mohammadfatemieh/Tigershark3D/PCB-Rev2/Project Outputs for Tigershark 3D rev2 PreProduction Thermistors Version/Rambott.xls

Sheet: BOM Report
Bill of Materials |  |  | <Parameter Title not found>
Source Data From: |  | Rambott
Project: |  | Rambott
Variant: |  | None
Creation Date: | 8/7/2015 | 12:21:47 PM
Print Date: | 2015-08-07 | 12:30:02
Footprint | Comment | LibRef | Designator | Description | Quantity
C0402 | 0402 | GRM155R71H103JA88D, GRM155R71H103JA88D, GRM155R71H103JA88D, GRM155R71H103JA88D, GRM155R71H103JA88D, GRM155R71H103JA88D, 100nF C0402 - GRM155R71C104KA88D, GRM155R71C104KA88D, GRM155R71C104KA88D, GRM155R71H103JA88D, GRM155R71H103JA88D, GRM155R71H103JA88D, GRM155R71H103JA88D, CL05C100JB5NNNC, CL05C100JB5NNNC, GRM155R71H103JA88D, GRM155R60J474KE19D, GRM155R71H103JA88D, GRM155R71H103JA88D, GRM155R71H103JA88D, GRM155R71H103JA88D, GRM155R71H103JA88D, GRM155R71H103JA88D, 100nF C0402 - GRM155R71C104KA88D, GRM155R60J474KE19D, GRM155R60J474KE19D, GRM155R60J474KE19D, GRM155R60J474KE19D, CL05C100JB5NNNC, GRM155R71H103JA88D, GRM155R71H103JA88D, GRM155R71H103JA88D, GRM155R71H103JA88D, GRM155R71H103JA88D, GRM155R71C104KA88D, GRM155R71C104KA88D, GRM155R71C104KA88D, GRM155R71H103JA88D | C1_ES1, C1_ES2, C1_ES3, C2_ES1, C2_ES2, C2_ES3, C18, C20, C26, C37_M1, C37_M2, C37_M3, C37_M4, C43, C44, C49, C50, C51, C63, C68_M1, C68_M2, C68_M3, C68_M4, C70, C71_M1, C71_M2, C71_M3, C71_M4, C73, C75_M1, C75_M2, C75_M3, C75_M4, C84, C85, C86, C87, C89 | CAP CER 10nF 50V X7R 0402, CAP CER 10nF 50V X7R 0402, CAP CER 10nF 50V X7R 0402, CAP CER 10nF 50V X7R 0402, CAP CER 10nF 50V X7R 0402, CAP CER 10nF 50V X7R 0402, Capacitor (Semiconductor SIM Model), CAP CER 0.1UF (100nF) 16V 10% X7R 0402, CAP CER 0.1UF (100nF) 16V 10% X7R 0402, CAP CER 10000PF 50V X7R 0402, CAP CER 10000PF 50V X7R 0402, CAP CER 10000PF 50V X7R 0402, CAP CER 10000PF 50V X7R 0402, CAP CER 10PF 50V 5% NP0 0402, CAP CER 10PF 50V 5% NP0 0402, CAP CER 10000PF 50V X7R 0402, 0.47uF 6.3v C0402 - GRM155R60J474KE19D, CAP CER 10000PF 50V X7R 0402, CAP CER 10nF 50V X7R 0402, CAP CER 10nF 50V X7R 0402, CAP CER 10nF 50V X7R 0402, CAP CER 10nF 50V X7R 0402, CAP CER 10nF 50V X7R 0402, Capacitor (Semiconductor SIM Model), 0.47uF 6.3v C0402 - GRM155R60J474KE19D, 0.47uF 6.3v C0402 - GRM155R60J474KE19D, 0.47uF 6.3v C0402 - GRM155R60J474KE19D, 0.47uF 6.3v C0402 - GRM155R60J474KE19D, CAP CER 10PF 50V 5% NP0 0402, CAP CER 10000PF 50V X7R 0402, CAP CER 10000PF 50V X7R 0402, CAP CER 10000PF 50V X7R 0402, CAP CER 10000PF 50V X7R 0402, CAP CER 10000PF 50V X7R 0402, CAP CER 0.1UF (100nF) 16V 10% X7R 0402, CAP CER 0.1UF (100nF) 16V 10% X7R 0402, CAP CER 0.1UF (100nF) 16V 10% X7R 0402, CAP CER 10000PF 50V X7R 0402 | 38
C0603 | 1nF | C0603C102K5RACTU | C3_M1, C3_M2, C3_M3, C3_M4, C5_M1, C5_M2, C5_M3, C5_M4, C6_M1, C6_M2, C6_M3, C6_M4, C8_M1, C8_M2, C8_M3, C8_M4, C52, C62, C67, C72, C79, C82, C83 | CAP CER 0603 1nF 50v 10% X7R | 23
C0805 | 47uF | CL21A476MQCLRNC | C4 | CAP CER 47UF 6.3V 20% X5R 0805 | 1
C1206 | 4.7uF | C1206C475K5PACTU | C9 | CAP CER 1206 4.7uF 50V 10% X5R | 1
C0805 | 1uF | GRM21BR71H105KA12L | C10 | CAP CER 0805 1uF 50V 10% X7R | 1
C0402 | 100nF | GRM155R71C104KA88D | C11, C23, C25, C27, C30_TR1, C30_TR2, C30_TR3, C30_TR4, C33, C34, C35, C38, C39, C41, C42, C45, C46, C47, C48, C53, C54, C56, C57, C58, C59, C61, C65, C66_M1, C66_M2, C66_M3, C66_M4, C74, C88 | CAP CER 0402 100nF 16V 10% X7R | 33
C0603 | 100nF | C0603C104K5RACTU | C12_M1, C12_M2, C12_M3, C12_M4, C14_M1, C14_M2, C14_M3, C14_M4, C31, C40, C64, C69, C78, C81 | CAP CER 0603 100nF 50V 10% X7R | 14
C0603 | 0603 | C1608JB0J106K080AB | C13, C17, C29, C32, C36, C60 | CAP CER 10UF 6.3V 10% JB 0603 | 6
EEE-1VA101XP | EEE-1VA101XP | EEE-1VA101XP | C15_M1, C15_M2, C15_M3, C15_M4, C16, C90, C91 | CAP ALUM 100UF 35V 20% SMD | 7
C0805 | 10uF | C0805C106K8PACTU | C21, C76 | CAP CER 0805 10uF 10V 10% X5R | 2
C0402 | 1uF | GRM155R60J105KE19D | C22, C28 | CAP CER 0402 1uF 6.3V 10% X5R | 2
C1206 | 10uF 50V | CL31A106KBHNNNE | C55, C77, C80 | CAP CER 10UF 50V 10% X5R 1206 | 3
SOD323-R | MM3Z2V7T1G | MM3Z2V7T1G | D1 | Z-Diode 2.7V 10mA 200mW | 1
SMA-SM | SK310A-TP | SK310A | D2 | DIODE Schottky 3A SMA | 1
SOD523 | 1N4148WT | 1N4148WT | D3_TR1, D3_TR2, D3_TR3, D3_TR4, D5_TR1, D5_TR2, D5_TR3, D5_TR4 | DIODE SOD523 | 8
DO-214AB | S3A-13-F | S3A-13-F | D4, D6, D7 | DIODE DO-214AB | 3
SOD323-R | RSB39VTE-17 | RSB39VTE-17 | D8, D9, D30, D32, D34, D35, D36, D37 | DIODE TVS | 8
LED2012120 | 5988140107F | 5988140107F | D10, D11, D13, D14, D16, D18, D29 | LED 0805 Yellow | 7
SMA-SM | B240A-13-F | SK310A | D12, D15, D17, D19, D31, D33 | DIODE Schottky 3A SMA | 6
SMA-SM | SMAJ30A | SMAJ30A | D20_M1, D20_M2, D20_M3, D20_M4, D21_M1, D21_M2, D21_M3, D21_M4, D22_M1, D22_M2, D22_M3, D22_M4, D23_M1, D23_M2, D23_M3, D23_M4, D25, D26, D27, D28 | DIODE TVS 30V SMA | 20
LED2012120 | 5988110107F | 5988110107F | D24 | LED 0805 Red | 1
SOD923-100X40-2N | ESD9B3.3ST5G | ESD9B3.3ST5G | D38_ES1, D38_ES2, D38_ES3, D39_ES1, D39_ES2, D39_ES3 | 11.5 V 15 pF SMT Transient Voltage Suppressor - SOD-923 | 6
SOT95P230X110-3N | PESDxL2BT | PESDxL2BT | DA4 | PESDxL2BT TVS Diode Array 2x | 1
3557 | 3557-2 | 3557-2 | F1, F2, F3 | FUSE PTH ATO | 3
70543-02 | C-GRID-02-70543 | C-GRID-02-70543 | FAN-1, P2_TR1, P2_TR2, P2_TR3, P2_TR4 | Connector 2pos | 5
PN61729 | USB-B | USB-B | J1 |  | 1
FTSH-105-XX-X-DV | FTSH-105-XX-X-DV | ARM Cortex JTAG-DEBUG Header | J2 |  | 1
XAL50xx-153 | XAL5050-153MEB | XAL5050-153MEB | L1 | IND 15uH 3.9A 20% | 1
C0805 | LQM21FN100M70L | LQM21FN100M70L | L2, L3, L4 | IND 0805 10uH 100mA 780 mOhm 20% | 3
LED2012120 | 5988170107F | 5988170107F | LED1 | LED 0805 Green | 1
OSHW_8X150_NOTEXT | OSHW_LOGO_8MILX0150-NT | OSHW_LOGO_8MILX0150-NT | LOGO1 |  | 1
4POL254 | Molex 0705430003 | Molex 0705430003 Alt | M1_M1, M1_M2, M1_M3, M1_M4, M2, M3, T2, T4 | Molex 4 Pin Clip Connector | 8
70543-03 | Molex 70543-03 | C-GRID-03-70543 | MAX1_ES1, MAX1_ES2, MAX1_ES3, MIN1_ES1, MIN1_ES2, MIN1_ES3 | Connector 2pos 2.54mm locking | 6
HDR2X5 | Header 5X2 | Header 5X2 | P3, P4 | Header, 5-Pin, Dual row | 2
HDR2X12 | Header 12X2 | Header 12X2 | P5 | Header, 12-Pin, Dual row | 1
SOIC8-dual-drain | PHN210T | PHN210T | Q1 | Dual N-channel TrenchMOS intermediate level FET | 1
SOT669 | PSMN7R0-60YS,115 | PSMN7R0-60YS,115 | Q4, Q5, Q6, Q7 | Mosfet N-channel 60V 356A 117W 9.3mOhms | 4
R0603 | 10K | ERJ-3EKF1002V | R1, R7 | RES 0603 10K 100mW 1% | 2
R0402 | 100K | RC1005F104CS | R2_ES1, R2_ES2, R2_ES3, R3_ES1, R3_ES2, R3_ES3, R6, R8_M1, R8_M2, R8_M3, R8_M4, R21, R53, R54, R58, R62, R66, R71, R72, R74, R75 | RES SMD 100K OHM 1% 1/16W 0402 | 21
R0402 | 24r | CRCW040224R0FKED | R5, R15, R16, R18, R20, R22, R85, R86, R89 | Res Thick Film 0402 24 Ohm 1% 0.063W | 9
R0402 | 10K | RC0402FR-0710KP | R9_M1, R9_M2, R9_M3, R9_M4, R27, R28, R29, R31_M1, R31_M2, R31_M3, R31_M4, R34, R35, R37, R40, R50, R73 | RES SMD 10K OHM 1% 1/16W 0402 | 17
R0603 | R0603TBD | R0603TBD | R10, R12 | Resistor | 2
R0603 | 1K | ERJ-3EKF1001V | R11, R25, R26 | RES 0603 1K 100mW 1% | 3
R0603 | 1.8K | RC0603JR-071K8L | R13, R47, R56, R60, R64, R68 | RES 0603 1.8K 100mW 5% | 6
R0603 | 4.7K | ERJ3EKF4701V | R14_TR1, R14_TR2, R14_TR3, R14_TR4, R19_TR1, R19_TR2, R19_TR3, R19_TR4, R42, R43 | RES 0603 4.7K 100mW 1% | 10
R0402 | 200K | CRCW0402200KFKED | R17 | RES 0402 200k 63mW 1% | 1
R0402 | 6.8K | CRCW04026K80FKED | R23 | RES SMD 6.8K OHM 1% 1/16W 0402 | 1
R0402 | 1M | ERJ2GEJ105X | R30_M1, R30_M2, R30_M3, R30_M4, R36 | RES 0402 1M 100mW 5% | 5
2512R-0.55 | 2512 | CSRN2512FTR100 | R32_M1, R32_M2, R32_M3, R32_M4, R33_M1, R33_M2, R33_M3, R33_M4, R38, R39 | RES SMD 0.1 OHM 1% 2W 2512 | 10
R0402 | 10R | RC0402FR-0710RL | R45, R46, R52, R55, R57, R59, R61, R63, R65, R67, R69, R70 | RES SMD 10K OHM 1% 1/16W 0402 | 12
2512R-0.55 | 0.6r | RL2512FK-070R06L | R51 | RES 0.06 OHM 1W 1% 2512 SMD | 1
R0402 | 1k | RK73H1ETTP1001F | R76_ES1, R76_ES2, R76_ES3, R77_ES1, R77_ES2, R77_ES3 | RES 0402 1k 63mW 1% | 6
B3F-31XX | 1571610-2 | 1571610-2 | S1 | SWTCH Momentary Washable | 1
KSC721JLFS | KSC721JLFS | KSC721JLFS | S2 | Switch SPST 1.7 N / 1.8 N J Bend Surface Mount Tactile Switch | 1
502570-0893 - Molex SD | 502570-0893 | 502570-0893 | SD | microSD 502570-0893 Molex Part | 1
MSTBV10 | Molex 0395311010 | 0395311010 - Molex 10 Position Connector | T1 | MSBTV10 10 port connector same as RAMBo | 1
VSSOP10 | LM25011MY/NOPB | LM25011 | U1 | REG BUCK | 1
TDFN1616-6LD-PL-1 | MIC5353-3.3YMT-TR | MIC5353-3.3YMT-TR | U2 | LDO 3.3V 500mA - low ESR Cout | 1
LQFP144_N | ATML-ATSAM3X-LQFP-144 | ATML-ATSAM3X-LQFP-144 | U3 |  | 1
SOT26P285X140-6L | ZXGD3009E6 | ZXGD3009E6 | U4, U8, U10, U11, U12, U13 | MOSFET DRVR 3A 1-OUT High Speed Non-Inv6-Pin SOT-26 T/R | 6
DRV8825PWPR | DRV8825 | DRV8825 | U5, U7_M1, U7_M2, U7_M3, U7_M4 | DRV8825 Ti Stepper Driver | 5
ADuM4160 | ADuM4160 | ADuM4160 | U6 | USB Opto Isolator | 1
S25FL216K0PMFI041 | S25FL216K0PMFI041 | S25FL216K0PMFI041 | U9 |  | 1
CRYS320250 | 405C35B12M00000 | 405C35B12M00000 | X2 | Crystal 12.0000MHz 10ppm 10pF | 1
 |  |  |  |  | 358
Approved |  | Notes

Sheet: Project Information
Project Full Path | C:\Users\johnny\Documents\GitHub\Tigershark3D\PCB-Rev2\Tigershark 3D rev2 PreProduction Thermistors Version.PrjPcb
Project Filename | Tigershark 3D rev2 PreProduction Thermistors Version.PrjPcb
Variant Name | None
Data-Source Filename | Tigershark 3D rev2 PreProduction Thermistors Version.PrjPcb
Data-Source Full Path | C:\Users\johnny\Documents\GitHub\Tigershark3D\PCB-Rev2\Tigershark 3D rev2 PreProduction Thermistors Version.PrjPcb
Title | <Parameter Title not found>
Total Quantity | 483
Report Time | 12:21:47 PM
Report Date | 8/7/2015
Report Date & Tine | 8/7/2015 12:21:47 PM
Output Name | Bill of Materials
Output Type | BOM_PartType
Output Generator Name | BOM
Output Generator Description | Bill of Materials
