mohammadfatemieh/Tigershark3D/PCB-Rev2/Project Outputs for Tigershark 3D rev2 PreProduction Thermistors Version/Tigershark 3D rev2 PreProduction Thermistors Version1.xlsx

Comment | Description | Designator | Footprint | LibRef | Quantity
4.7nF, 4.7nF, 4.7nF, 4.7nF, 4.7nF, 4.7nF, 100nF, 0402, 4.7nF, 0402, 1uF, 100nF, 0402, 0402, 100nF, 1uF, 100nF, 100nF, 100nF, 100nF, 100nF, 100nF, 100nF, 100nF, 100nF, 100nF, 100nF, 0402, 0402, 100nF, 100nF, 100nF, 100nF, 0402, 0402, 0402, 100nF, 100nF, 100nF, 100nF, 100nF, 100nF, 100nF, 100nF, 100nF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
1nF, 1nF, 1nF, 1nF, 1nF, 1nF, 1nF, 1nF, 1nF, 1nF, 1nF, 1nF, 1nF, 1nF, 1nF, 1nF, 100nF, 100nF, 100nF, 100nF, 0603, 100nF, 100nF, 100nF, 100nF, 0603, 0603, 100nF, 0603, 0603, 100nF, 1nF, 0603, 1nF, 100nF, 1nF, 100nF, 1nF, 100nF, 1nF, 100nF, 1nF, 1nF | CAP CER 0603 1nF 50v 10% X7R, CAP CER 0603 1nF 50v 10% X7R, CAP CER 0603 1nF 50v 10% X7R, CAP CER 0603 1nF 50v 10% X7R, CAP CER 0603 1nF 50v 10% X7R, CAP CER 0603 1nF 50v 10% X7R, CAP CER 0603 1nF 50v 10% X7R, CAP CER 0603 1nF 50v 10% X7R, CAP CER 0603 1nF 50v 10% X7R, CAP CER 0603 1nF 50v 10% X7R, CAP CER 0603 1nF 50v 10% X7R, CAP CER 0603 1nF 50v 10% X7R, CAP CER 0603 1nF 50v 10% X7R, CAP CER 0603 1nF 50v 10% X7R, CAP CER 0603 1nF 50v 10% X7R, CAP CER 0603 1nF 50v 10% X7R, CAP CER 0603 100nF 50V 10% X7R, CAP CER 0603 100nF 50V 10% X7R, CAP CER 0603 100nF 50V 10% X7R, CAP CER 0603 100nF 50V 10% X7R, CAP CER 10UF 6.3V 10% JB 0603, CAP CER 0603 100nF 50V 10% X7R, CAP CER 0603 100nF 50V 10% X7R, CAP CER 0603 100nF 50V 10% X7R, CAP CER 0603 100nF 50V 10% X7R, CAP CER 10UF 6.3V 10% JB 0603, CAP CER 10UF 6.3V 10% JB 0603, CAP CER 0603 100nF 50V 10% X7R, CAP CER 10UF 6.3V 10% JB 0603, CAP CER 10UF 6.3V 10% JB 0603, CAP CER 0603 100nF 50V 10% X7R, CAP CER 0603 1nF 50v 10% X7R, CAP CER 10UF 6.3V 10% JB 0603, CAP CER 0603 1nF 50v 10% X7R, CAP CER 0603 100nF 50V 10% X7R, CAP CER 0603 1nF 50v 10% X7R, CAP CER 0603 100nF 50V 10% X7R, CAP CER 0603 1nF 50v 10% X7R, CAP CER 0603 100nF 50V 10% X7R, CAP CER 0603 1nF 50v 10% X7R, CAP CER 0603 100nF 50V 10% X7R, CAP CER 0603 1nF 50v 10% X7R, CAP CER 0603 1nF 50v 10% X7R | C3_M1, C3_M2, C3_M3, C3_M4, C5_M1, C5_M2, C5_M3, C5_M4, C6_M1, C6_M2, C6_M3, C6_M4, C8_M1, C8_M2, C8_M3, C8_M4, C12_M1, C12_M2, C12_M3, C12_M4, C13, C14_M1, C14_M2, C14_M3, C14_M4, C17, C29, C31, C32, C36, C40, C52, C60, C62, C64, C67, C69, C72, C78, C79, C81, C82, C83 | C0603 | C0603C102K5RACTU, C0603C102K5RACTU, C0603C102K5RACTU, C0603C102K5RACTU, C0603C102K5RACTU, C0603C102K5RACTU, C0603C102K5RACTU, C0603C102K5RACTU, C0603C102K5RACTU, C0603C102K5RACTU, C0603C102K5RACTU, C0603C102K5RACTU, C0603C102K5RACTU, C0603C102K5RACTU, C0603C102K5RACTU, C0603C102K5RACTU, C0603C104K5RACTU, C0603C104K5RACTU, C0603C104K5RACTU, C0603C104K5RACTU, C1608JB0J106K080AB, C0603C104K5RACTU, C0603C104K5RACTU, C0603C104K5RACTU, C0603C104K5RACTU, C1608JB0J106K080AB, C1608JB0J106K080AB, C0603C104K5RACTU, C1608JB0J106K080AB, C1608JB0J106K080AB, C0603C104K5RACTU, C0603C102K5RACTU, C1608JB0J106K080AB, C0603C102K5RACTU, C0603C104K5RACTU, C0603C102K5RACTU, C0603C104K5RACTU, C0603C102K5RACTU, C0603C104K5RACTU, C0603C102K5RACTU, C0603C104K5RACTU, C0603C102K5RACTU, C0603C102K5RACTU | 43
47uF, 1uF, 10uF, 10uF, LQM21FN100M70L, LQM21FN100M70L, LQM21FN100M70L | CAP CER 47UF 6.3V 20% X5R 0805, CAP CER 0805 1uF 50V 10% X7R, CAP CER 0805 10uF 10V 10% X5R, CAP CER 0805 10uF 10V 10% X5R, IND 0805 10uH 100mA 780 mOhm 20%, IND 0805 10uH 100mA 780 mOhm 20%, IND 0805 10uH 100mA 780 mOhm 20% | C4, C10, C21, C76, L2, L3, L4 | C0805 | CL21A476MQCLRNC, GRM21BR71H105KA12L, C0805C106K8PACTU, C0805C106K8PACTU, LQM21FN100M70L, LQM21FN100M70L, LQM21FN100M70L | 7
470uF | CAP ALU 470uF 50V 20% | C7 | C12,5-5 | UPW1H471MHD1TO | 1
4.7uF, 10uF 50V, 10uF 50V, 10uF 50V | CAP CER 1206 4.7uF 50V 10% X5R, CAP CER 10UF 50V 10% X5R 1206, CAP CER 10UF 50V 10% X5R 1206, CAP CER 10UF 50V 10% X5R 1206 | C9, C55, C77, C80 | C1206 | C1206C475K5PACTU, CL31A106KBHNNNE, CL31A106KBHNNNE, CL31A106KBHNNNE | 4
EEE-1VA101XP | CAP ALUM 100UF 35V 20% SMD | C15, C16 | EEE-1VA101XP | EEE-1VA101XP | 2
SZMM3Z4V7T1G, RSB39VTE-17, RSB39VTE-17 | Z-Diode 2.7V 10mA 200mW, DIODE TVS, DIODE TVS | D1, D8, D9 | SOD323-R | MM3Z2V7T1G, RSB39VTE-17, RSB39VTE-17 | 3
SK310A-TP, SMAJ30A, SMAJ30A, SMAJ30A, SMAJ30A, SMAJ30A, SMAJ30A, SMAJ30A, SMAJ30A, SMAJ30A, SMAJ30A, SMAJ30A, SMAJ30A, SMAJ30A, SMAJ30A, SMAJ30A, SMAJ30A, SMAJ30A, SMAJ30A, SMAJ30A, SMAJ30A | DIODE Schottky 3A SMA, DIODE TVS 30V SMA, DIODE TVS 30V SMA, DIODE TVS 30V SMA, DIODE TVS 30V SMA, DIODE TVS 30V SMA, DIODE TVS 30V SMA, DIODE TVS 30V SMA, DIODE TVS 30V SMA, DIODE TVS 30V SMA, DIODE TVS 30V SMA, DIODE TVS 30V SMA, DIODE TVS 30V SMA, DIODE TVS 30V SMA, DIODE TVS 30V SMA, DIODE TVS 30V SMA, DIODE TVS 30V SMA, DIODE TVS 30V SMA, DIODE TVS 30V SMA, DIODE TVS 30V SMA, DIODE TVS 30V SMA | D2, D20_M1, D20_M2, D20_M3, D20_M4, D21_M1, D21_M2, D21_M3, D21_M4, D22_M1, D22_M2, D22_M3, D22_M4, D23_M1, D23_M2, D23_M3, D23_M4, D25, D26, D27, D28 | SMA-SM | SK310A, SMAJ30A, SMAJ30A, SMAJ30A, SMAJ30A, SMAJ30A, SMAJ30A, SMAJ30A, SMAJ30A, SMAJ30A, SMAJ30A, SMAJ30A, SMAJ30A, SMAJ30A, SMAJ30A, SMAJ30A, SMAJ30A, SMAJ30A, SMAJ30A, SMAJ30A, SMAJ30A | 21
1N4148WT | DIODE SOD523 | D3_TR1, D3_TR2, D3_TR3, D3_TR4, D5_TR1, D5_TR2, D5_TR3, D5_TR4 | SOD523 | 1N4148WT | 8
S3A-13-F | DIODE DO-214AB | D4, D6, D7 | DO-214AB | S3A-13-F | 3
5988140107F, 5988140107F, 5988140107F, 5988140107F, 5988140107F, 5988140107F, 5988140107F, 5988140107F, 5988170107F | LED 0805 Yellow, LED 0805 Yellow, LED 0805 Yellow, LED 0805 Yellow, LED 0805 Yellow, LED 0805 Yellow, LED 0805 Yellow, LED 0805 Yellow, LED 0805 Green | D10, D11, D13, D14, D16, D18, D24, D29, LED1 | LED2012120 | 5988140107F, 5988140107F, 5988140107F, 5988140107F, 5988140107F, 5988140107F, 5988140107F, 5988140107F, 5988170107F | 9
B240A-13-F | Schottky Diode | D12, D15, D17, D19 | SK310A-TP | D Schottky | 4
PESDxL2BT | PESDxL2BT TVS Diode Array 2x | DA1, DA2, DA3, DA4 | SOT95P230X110-3N | PESDxL2BT | 4
3557-2 | FUSE PTH ATO | F1, F2, F3 | 3557 | 3557-2 | 3
C-GRID-02-70543 | Connector 2pos | FAN-1, P2_TR1, P2_TR2, P2_TR3, P2_TR4 | 70543-02 | C-GRID-02-70543 | 5
FIDUCIAL |  | FD1, FD2, FD3 | FIDUCIAL-1X2 | FIDUCIAL | 3
TP4 | Socket | GND_TP, TP1_M1, TP1_M2, TP1_M3, TP1_M4, TP2, TP3, TP4, TP5, TP6, TP7, TP8, TP9_ES1, TP9_ES2, TP9_ES3, TP10_ES1, TP10_ES2, TP10_ES3, TP11, TP12, TP13, TP14, TP15, TP16, TP17, TP18, TP19, TP20, TP21, TP22, TP23, TP24_M1, TP24_M2, TP24_M3, TP24_M4, TP25_M1, TP25_M2, TP25_M3, TP25_M4, TP26_M1, TP26_M2, TP26_M3, TP26_M4, TP27_M1, TP27_M2, TP27_M3, TP27_M4, TP28, TP29, TP30, TP31, TP32_M1, TP32_M2, TP32_M3, TP32_M4, TP33_M1, TP33_M2, TP33_M3, TP33_M4, TP34, TP35_M1, TP35_M2, TP35_M3, TP35_M4, TP36_M1, TP36_M2, TP36_M3, TP36_M4, TP37_M1, TP37_M2, TP37_M3, TP37_M4, TP38, TP39_M1, TP39_M2, TP39_M3, TP39_M4, TP40_M1, TP40_M2, TP40_M3, TP40_M4, TP41, TP42, TP43, TP44, TP45, TP46, TP47, TP48, TP49, TP50, TP51, TP52_TR1, TP52_TR2, TP52_TR3, TP52_TR4, TP53, TP54, TP55, TP56, TP57, TP58, TP59, TP60, TP61, TP62 | TP-2 | Socket | 106
USB-B |  | J1 | PN61729 | USB-B | 1
FTSH-105-XX-X-DV |  | J2 | FTSH-105-XX-X-DV | ARM Cortex JTAG-DEBUG Header | 1
SJ | SMD solder jumper | JP1 | SJ | SJ | 1
XAL5050-153MEB | IND 15uH 3.9A 20% | L1 | XAL50XX-153 | XAL5050-153MEB | 1
OSHW_LOGO_8MILX0150-NT |  | LOGO1 | OSHW_8X150_NOTEXT | OSHW_LOGO_8MILX0150-NT | 1
Molex 0705430003 | Molex 4 Pin Clip Connector | M1_M1, M1_M2, M1_M3, M1_M4, M2, M3, T4 | 4POL254 | Molex 0705430003 Alt | 7
Molex 70543-03 | Connector 2pos 2.54mm locking | MAX1_ES1, MAX1_ES2, MAX1_ES3, MIN1_ES1, MIN1_ES2, MIN1_ES3 | 70543-03 | C-GRID-03-70543 | 6
ERASE | Header, 2-Pin | P1 | HDR1X2 | Header 2 | 1
Header 5X2 | Header, 5-Pin, Dual row | P3, P4, P5, P6 | HDR2X5 | Header 5X2 | 4
NCV8402AD |  | Q1 | NCV8402AD-SOIC8 | NCV8402AD | 1
PSMN7R0-60YS,115 | Mosfet N-channel 60V 356A 117W 9.3mOhms | Q4, Q5, Q6, Q7 | SOT669 | PSMN7R0-60YS,115 | 4
10K, 10K, 10K, 1K, 10K, 1.8K, 4.7K, 4.7K, 4.7K, 4.7K, 24r, 24r, 24r, 4.7K, 4.7K, 4.7K, 4.7K, 24r, 10K, 1K, 1K, 10K, 10K, 10K, 10K, 10K, 4.7K, 4.7K, 10r, 1.8K, 10r, 1.8K, 10r, 1.8K, 10r, 1.8K, 10r, 1.8K, 10r | RES 0603 10K 100mW 1%, RES 0603 10K 100mW 1%, RES 0603 10K 100mW 1%, RES 0603 1K 100mW 1%, RES 0603 10K 100mW 1%, RES 0603 1.8K 100mW 5%, RES 0603 4.7K 100mW 1%, RES 0603 4.7K 100mW 1%, RES 0603 4.7K 100mW 1%, RES 0603 4.7K 100mW 1%, RES SMD 24 OHM 1% 1/10W 0603, RES SMD 24 OHM 1% 1/10W 0603, RES SMD 24 OHM 1% 1/10W 0603, RES 0603 4.7K 100mW 1%, RES 0603 4.7K 100mW 1%, RES 0603 4.7K 100mW 1%, RES 0603 4.7K 100mW 1%, RES SMD 24 OHM 1% 1/10W 0603, RES 0603 10K 100mW 1%, RES 0603 1K 100mW 1%, RES 0603 1K 100mW 1%, RES 0603 10K 100mW 1%, RES 0603 10K 100mW 1%, RES 0603 10K 100mW 1%, RES 0603 10K 100mW 1%, RES 0603 10K 100mW 1%, RES 0603 4.7K 100mW 1%, RES 0603 4.7K 100mW 1%, RES 0603 10r 100mW 1%, RES 0603 1.8K 100mW 5%, RES 0603 10r 100mW 1%, RES 0603 1.8K 100mW 5%, RES 0603 10r 100mW 1%, RES 0603 1.8K 100mW 5%, RES 0603 10r 100mW 1%, RES 0603 1.8K 100mW 5%, RES 0603 10r 100mW 1%, RES 0603 1.8K 100mW 5%, RES 0603 10r 100mW 1% | R1, R7, R10, R11, R12, R13, R14_TR1, R14_TR2, R14_TR3, R14_TR4, R15, R16, R18, R19_TR1, R19_TR2, R19_TR3, R19_TR4, R20, R21, R25, R26, R28, R29, R34, R35, R40, R42, R43, R45, R47, R52, R56, R58, R60, R62, R64, R66, R68, R70 | R0603 | ERJ-3EKF1002V, ERJ-3EKF1002V, ERJ-3EKF1002V, ERJ-3EKF1001V, ERJ-3EKF1002V, RC0603JR-071K8L, ERJ3EKF4701V, ERJ3EKF4701V, ERJ3EKF4701V, ERJ3EKF4701V, RC1608F240CS, RC1608F240CS, RC1608F240CS, ERJ3EKF4701V, ERJ3EKF4701V, ERJ3EKF4701V, ERJ3EKF4701V, RC1608F240CS, ERJ-3EKF1002V, ERJ-3EKF1001V, ERJ-3EKF1001V, ERJ-3EKF1002V, ERJ-3EKF1002V, ERJ-3EKF1002V, ERJ-3EKF1002V, ERJ-3EKF1002V, ERJ3EKF4701V, ERJ3EKF4701V, CRCW060310R0FKEA, RC0603JR-071K8L, CRCW060310R0FKEA, RC0603JR-071K8L, CRCW060310R0FKEA, RC0603JR-071K8L, CRCW060310R0FKEA, RC0603JR-071K8L, CRCW060310R0FKEA, RC0603JR-071K8L, CRCW060310R0FKEA | 39
2.7K, 2.7K, 2.7K, 2.7K, 2.7K, 2.7K, NP, NP, NP, NP, 39r, 100K, 2.7K, 2.7K, 2.7K, 2.7K, 200K, 39r, 6.8K, 1M, 2.7K, 1M, 1M, 1M, 1M, 2.7K, 2.7K, 2.7K, 2.7K, 1M, 2.7K, 1M, NP, NP, NP, NP, 100K, NP, NP, 100K, 100K, 100K, 100K, 100K | RES SMD 2.7K OHM 5% 1/10W 0402, RES SMD 2.7K OHM 5% 1/10W 0402, RES SMD 2.7K OHM 5% 1/10W 0402, RES SMD 2.7K OHM 5% 1/10W 0402, RES SMD 2.7K OHM 5% 1/10W 0402, RES SMD 2.7K OHM 5% 1/10W 0402, Resistor, Resistor, Resistor, Resistor, RES SMD 39 OHM 1% 1/10W 0402, RES SMD 100K OHM 1% 1/16W 0402, RES SMD 2.7K OHM 1% 1/10W 0402, RES SMD 2.7K OHM 1% 1/10W 0402, RES SMD 2.7K OHM 1% 1/10W 0402, RES SMD 2.7K OHM 1% 1/10W 0402, RES 0402 22r 63mW 1%, RES SMD 39 OHM 1% 1/10W 0402, RES SMD 6.8K OHM 1% 1/16W 0402, RES 0402 1M 100mW 5%, RES SMD 2.7K OHM 1% 1/10W 0402, RES 0402 1M 100mW 5%, RES 0402 1M 100mW 5%, RES 0402 1M 100mW 5%, RES 0402 1M 100mW 5%, RES SMD 2.7K OHM 1% 1/10W 0402, RES SMD 2.7K OHM 1% 1/10W 0402, RES SMD 2.7K OHM 1% 1/10W 0402, RES SMD 2.7K OHM 1% 1/10W 0402, RES 0402 1M 100mW 5%, RES SMD 2.7K OHM 1% 1/10W 0402, RES 0402 1M 100mW 5%, Resistor, Resistor, Resistor, Resistor, RES SMD 100K OHM 1% 1/16W 0402, Resistor, Resistor, RES SMD 100K OHM 1% 1/16W 0402, RES SMD 100K OHM 1% 1/16W 0402, RES SMD 100K OHM 1% 1/16W 0402, RES SMD 100K OHM 1% 1/16W 0402, RES SMD 100K OHM 1% 1/16W 0402 | R2_ES1, R2_ES2, R2_ES3, R3_ES1, R3_ES2, R3_ES3, R4_M1, R4_M2, R4_M3, R4_M4, R5, R6, R8_M1, R8_M2, R8_M3, R8_M4, R17, R22, R23, R24, R27, R30_M1, R30_M2, R30_M3, R30_M4, R31_M1, R31_M2, R31_M3, R31_M4, R36, R37, R41, R44_M1, R44_M2, R44_M3, R44_M4, R46, R48, R49, R55, R59, R63, R67, R71 | R0402 | ERJ-2GEJ272X, ERJ-2GEJ272X, ERJ-2GEJ272X, ERJ-2GEJ272X, ERJ-2GEJ272X, ERJ-2GEJ272X, Resistor, Resistor, Resistor, Resistor, ERJ-2RKF39R0X, RC1005F104CS, ERJ-2RKF2701X, ERJ-2RKF2701X, ERJ-2RKF2701X, ERJ-2RKF2701X, CRCW0402200KFKED, ERJ-2RKF39R0X, CRCW04026K80FKED, ERJ2GEJ105X, ERJ-2RKF2701X, ERJ2GEJ105X, ERJ2GEJ105X, ERJ2GEJ105X, ERJ2GEJ105X, ERJ-2RKF2701X, ERJ-2RKF2701X, ERJ-2RKF2701X, ERJ-2RKF2701X, ERJ2GEJ105X, ERJ-2RKF2701X, ERJ2GEJ105X, Resistor, Resistor, Resistor, Resistor, RC1005F104CS, Resistor, Resistor, RC1005F104CS, RC1005F104CS, RC1005F104CS, RC1005F104CS, RC1005F104CS | 44
0.6r, 2512, 2512, 2512, 2512, 2512, 2512, 2512, 2512, 2512, 2512 | RES 0.06 OHM 1W 1% 2512 SMD, RES SMD 0.1 OHM 1% 2W 2512, RES SMD 0.1 OHM 1% 2W 2512, RES SMD 0.1 OHM 1% 2W 2512, RES SMD 0.1 OHM 1% 2W 2512, RES SMD 0.1 OHM 1% 2W 2512, RES SMD 0.1 OHM 1% 2W 2512, RES SMD 0.1 OHM 1% 2W 2512, RES SMD 0.1 OHM 1% 2W 2512, RES SMD 0.1 OHM 1% 2W 2512, RES SMD 0.1 OHM 1% 2W 2512 | R9, R32_M1, R32_M2, R32_M3, R32_M4, R33_M1, R33_M2, R33_M3, R33_M4, R38, R39 | 2512R-0.55 | RL2512FK-070R06L, CSRN2512FTR100, CSRN2512FTR100, CSRN2512FTR100, CSRN2512FTR100, CSRN2512FTR100, CSRN2512FTR100, CSRN2512FTR100, CSRN2512FTR100, CSRN2512FTR100, CSRN2512FTR100 | 11
1571610-2 | SWTCH Momentary Washable | S1 | B3F-31XX | 1571610-2 | 1
502570-0893 | microSD 502570-0893 Molex Part | SD | 502570-0893 - Molex SD | 502570-0893 | 1
Molex 0395311010 | MSBTV10 10 port connector same as RAMBo | T1 | MSTBV10 | 0395311010 - Molex 10 Position Connector | 1
MSTBV6 | PHOENIX | T3 | MSTBV6 | MSTBV6 | 1
LM25011MY/NOPB | REG BUCK | U1 | VSSOP10 | LM25011 | 1
MIC5353-3.3YMT-TR | LDO 3.3V 500mA - low ESR Cout | U2 | TDFN1616-6LD-PL-1 | MIC5353-3.3YMT-TR | 1
ATML-ATSAM3X-LQFP-144 |  | U3 | LQFP144_N | ATML-ATSAM3X-LQFP-144 | 1
DRV8825 | DRV8825 Ti Stepper Driver | U5, U7_M1, U7_M2, U7_M3, U7_M4 | DRV8825PWPR | DRV8825 | 5
ADuM4160 | USB Opto Isolator | U6 | ADuM4160 | ADuM4160 | 1
TXB0106 Level Shifter | TXB0106 - Bidriectional Opendrain/pushpull level shift | U8 | TSOP65P640X120-16N | TXB0106 | 1
S25FL216K0PMFI041 |  | U9 | S25FL216K0PMFI041 | S25FL216K0PMFI041 | 1
7M-12.000MEEQ-T | Crystal 12.0000MHz 10ppm 10pF | X2 | CRYS320250 | 7M-12.000MEEQ-T | 1
