mohammadfatemieh/Tigershark3D/Schematic Prints.pdf

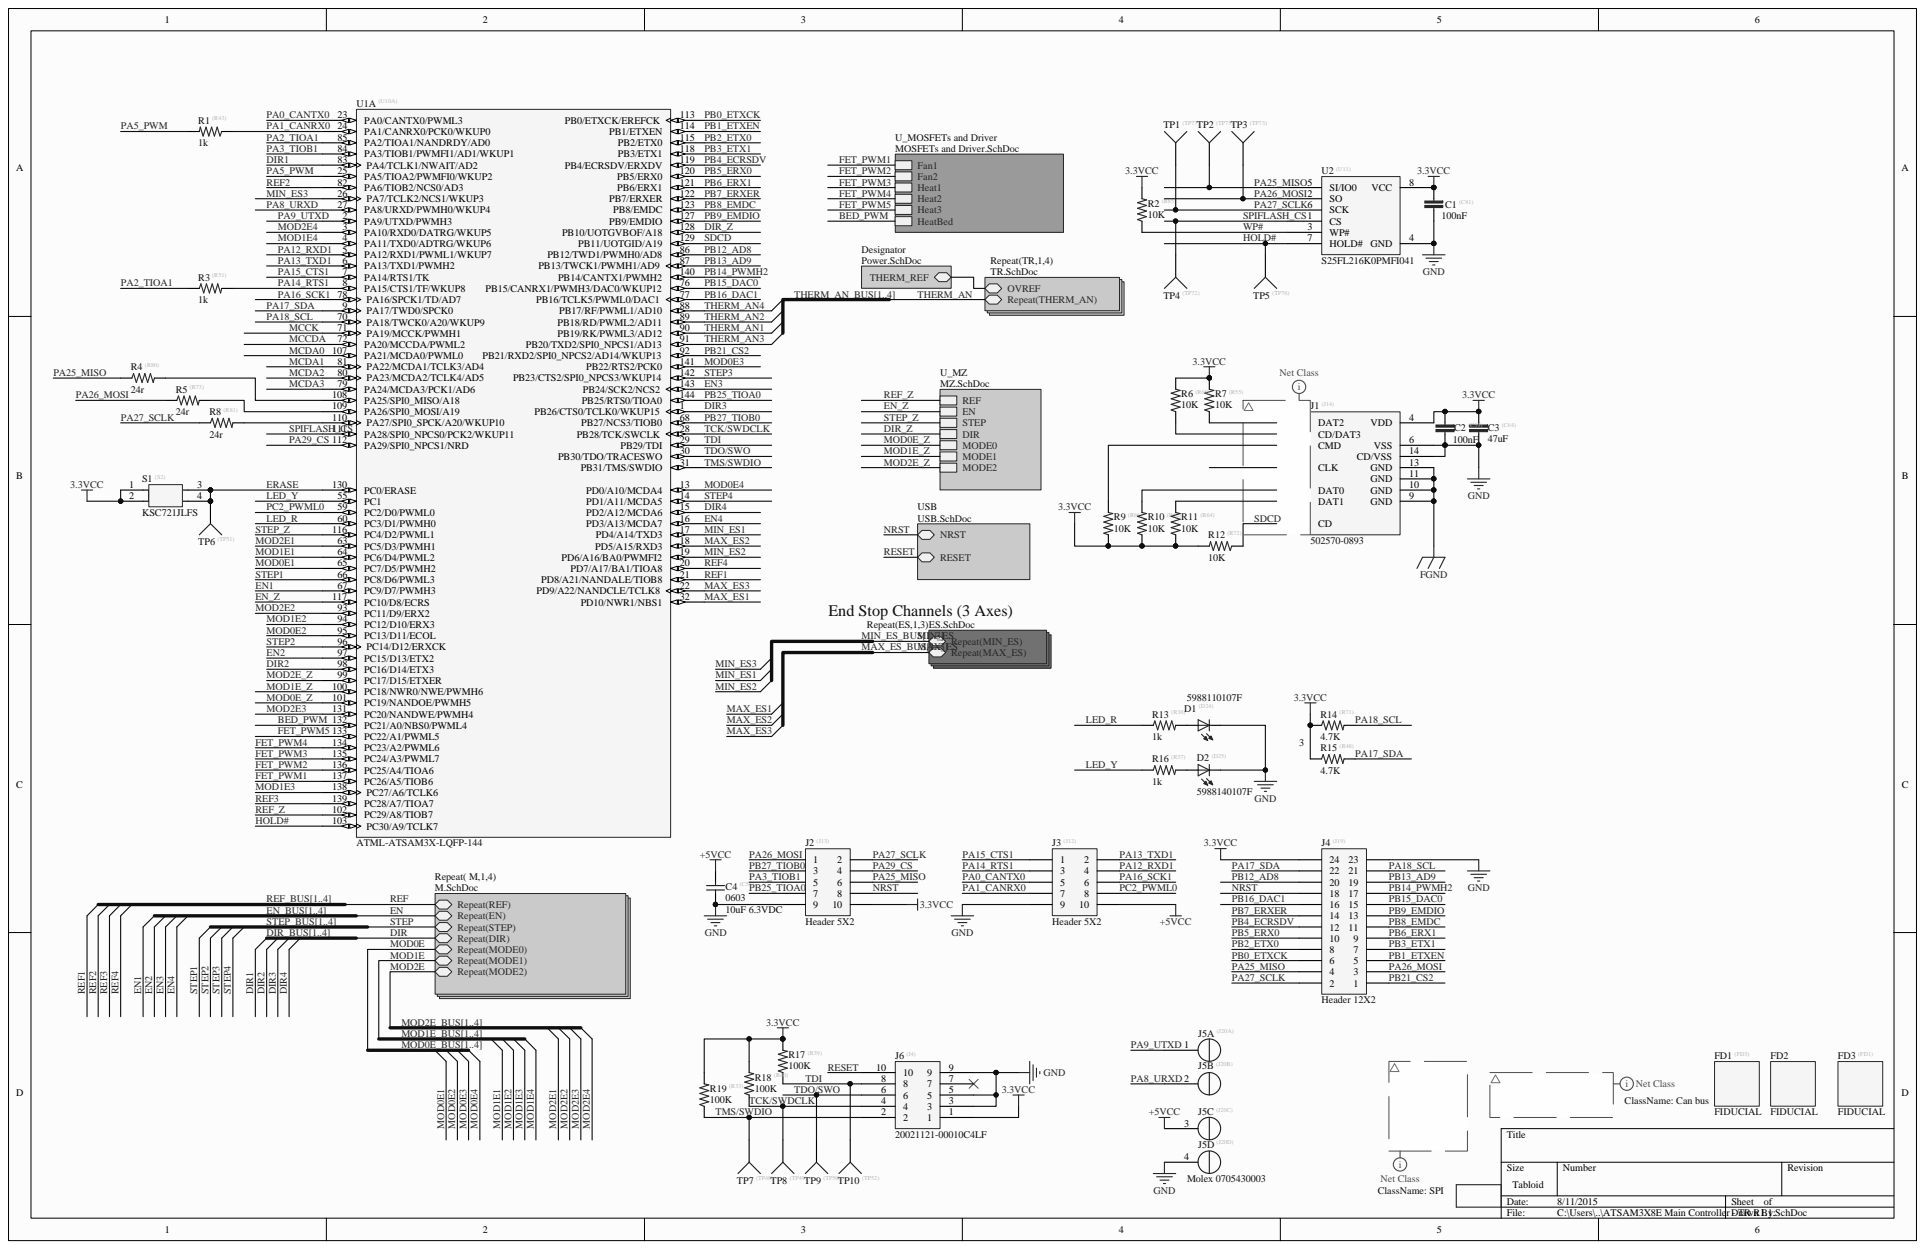
[picture p1: page 1]

End Stop Channels (3 Axes)

Size Tabloid | Number | Revision

Date: 8/11/2015 | Sheet of
File: C:\Users\..\ATSAM3X8E Main Controller - TR R1.1.SchDoc Drawn By:

A | A
XOUT 35 | XIN 36 | DHSDP | 37

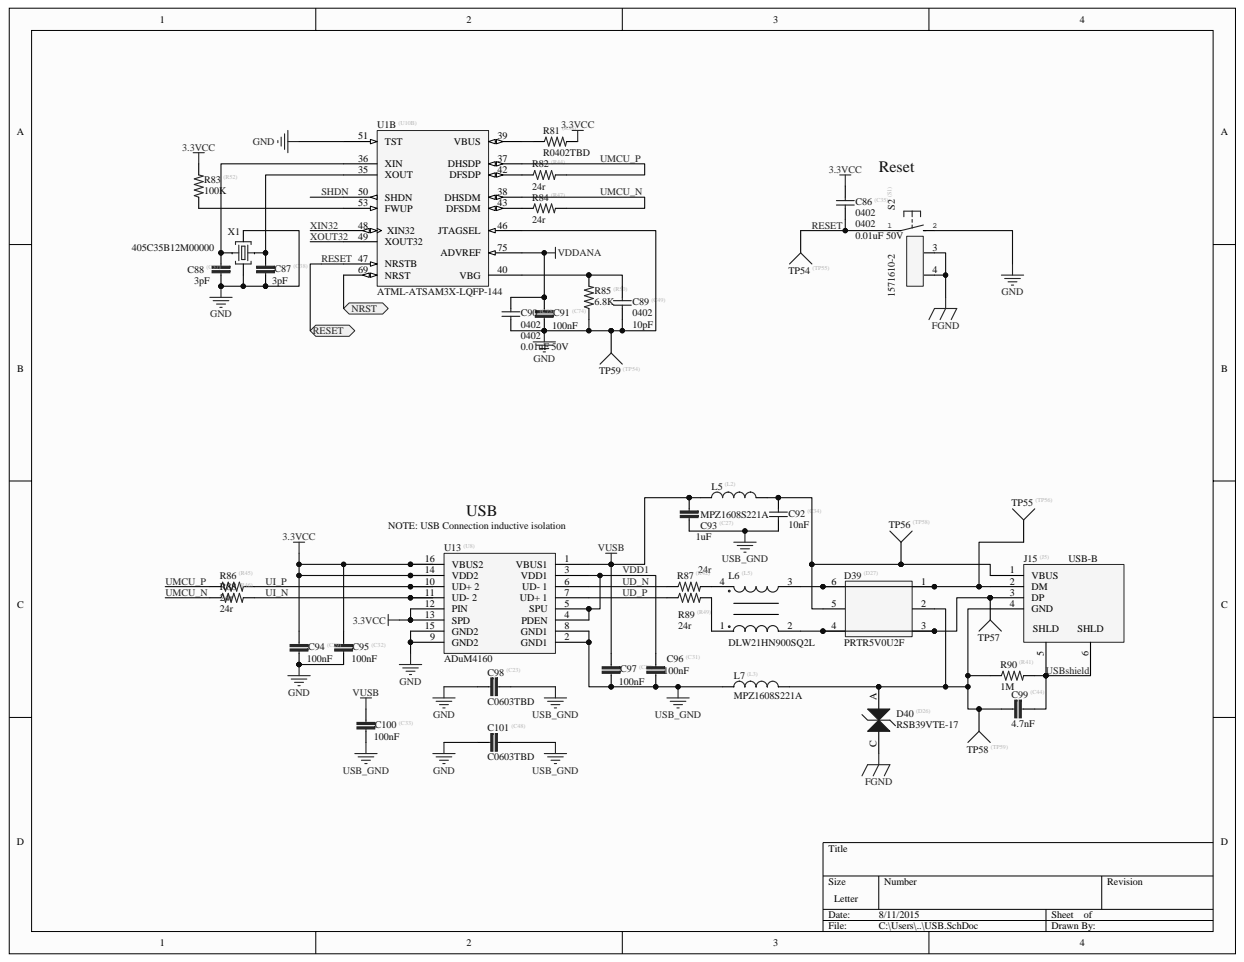
[picture p2: page 2]

NOTE: USB Connection inductive isolation

Size Letter | Number | Revision

Date: 8/11/2015 | Sheet of
File: C:\Users\..\USB.SchDoc | Drawn By:

A | A

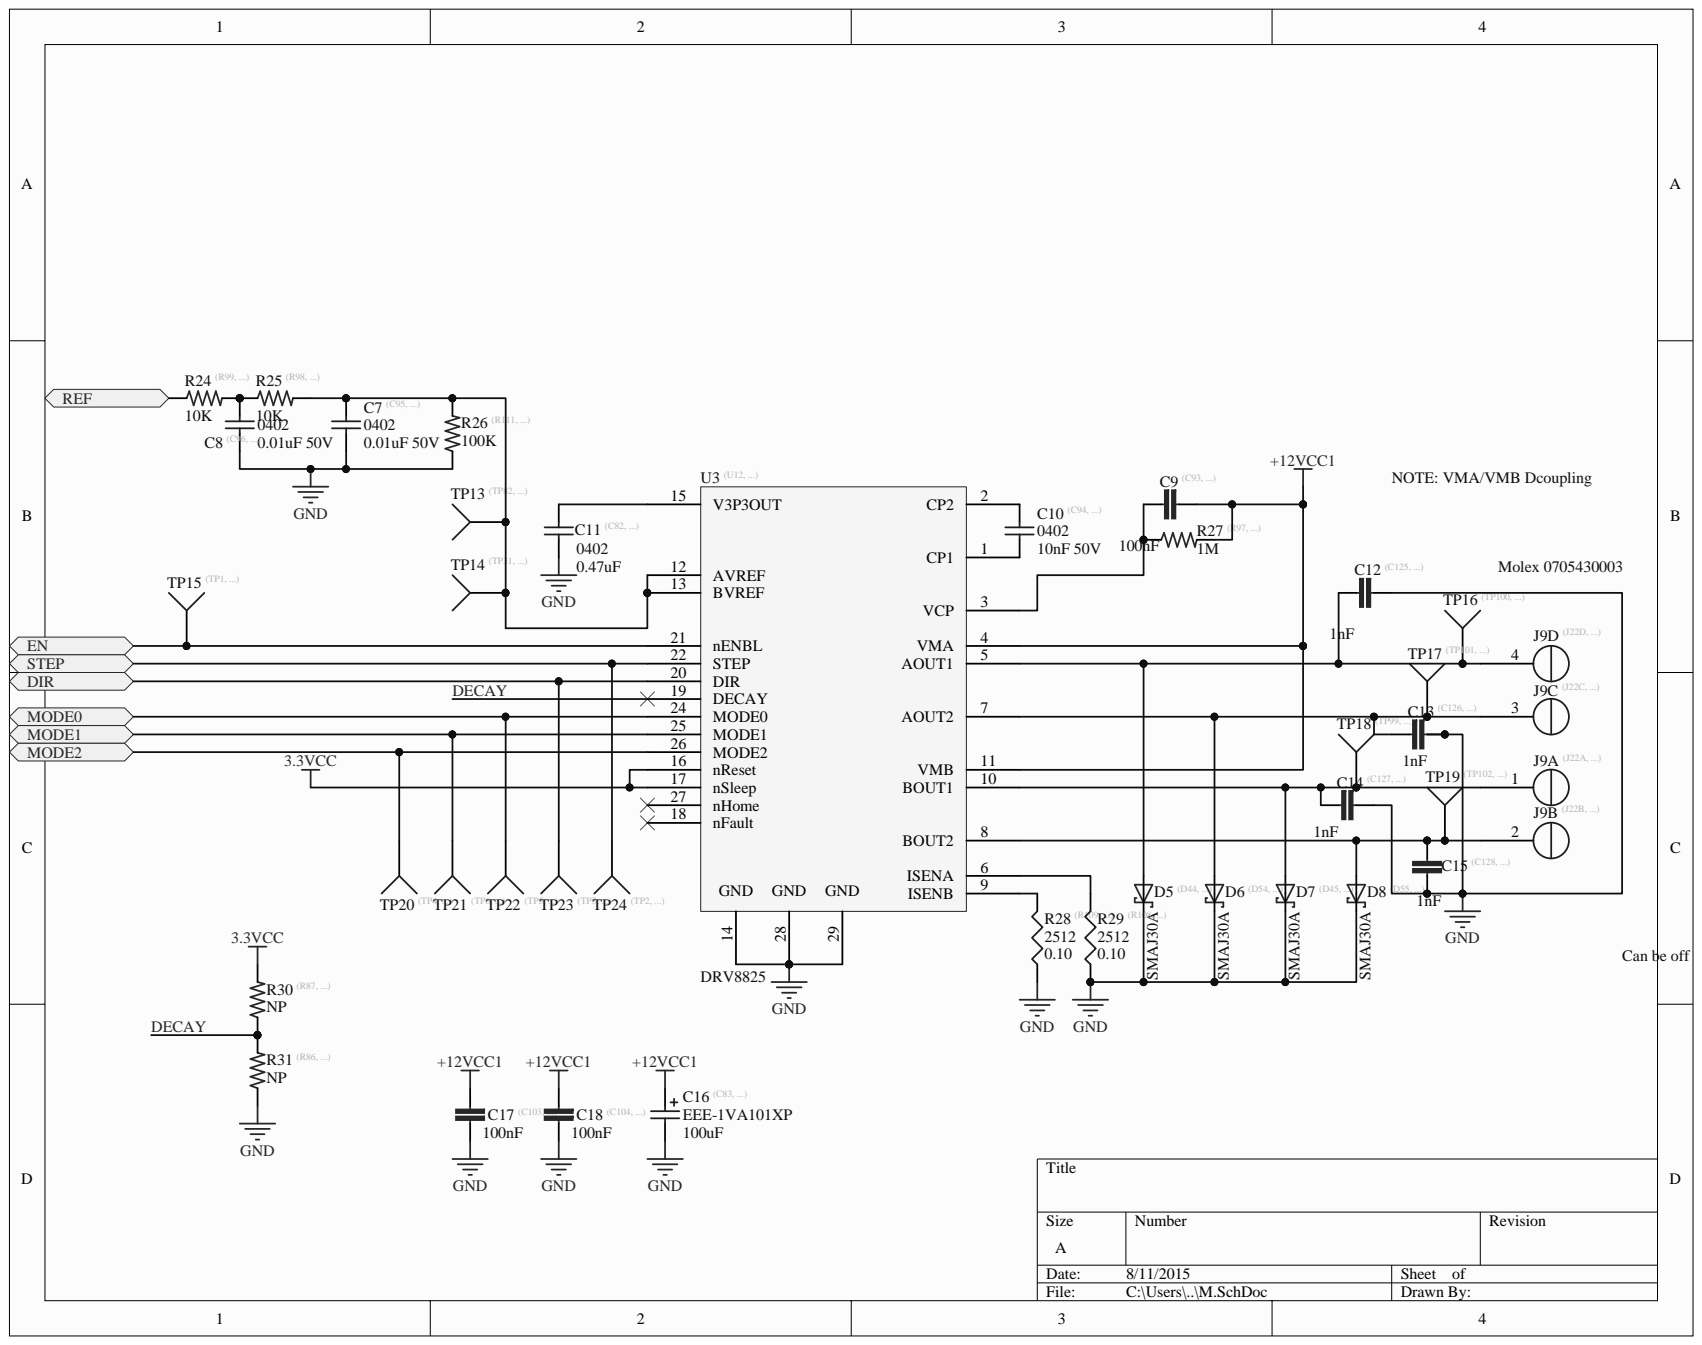
[picture p3: page 3]

NOTE: VMA/VMB Dcoupling

MODE0 24 MODE1 25 MODE2 26 nReset 16 nSleep 17

nHome 27 nFault 18

A | A

# NOTE: VMA/VMB Dcoupling

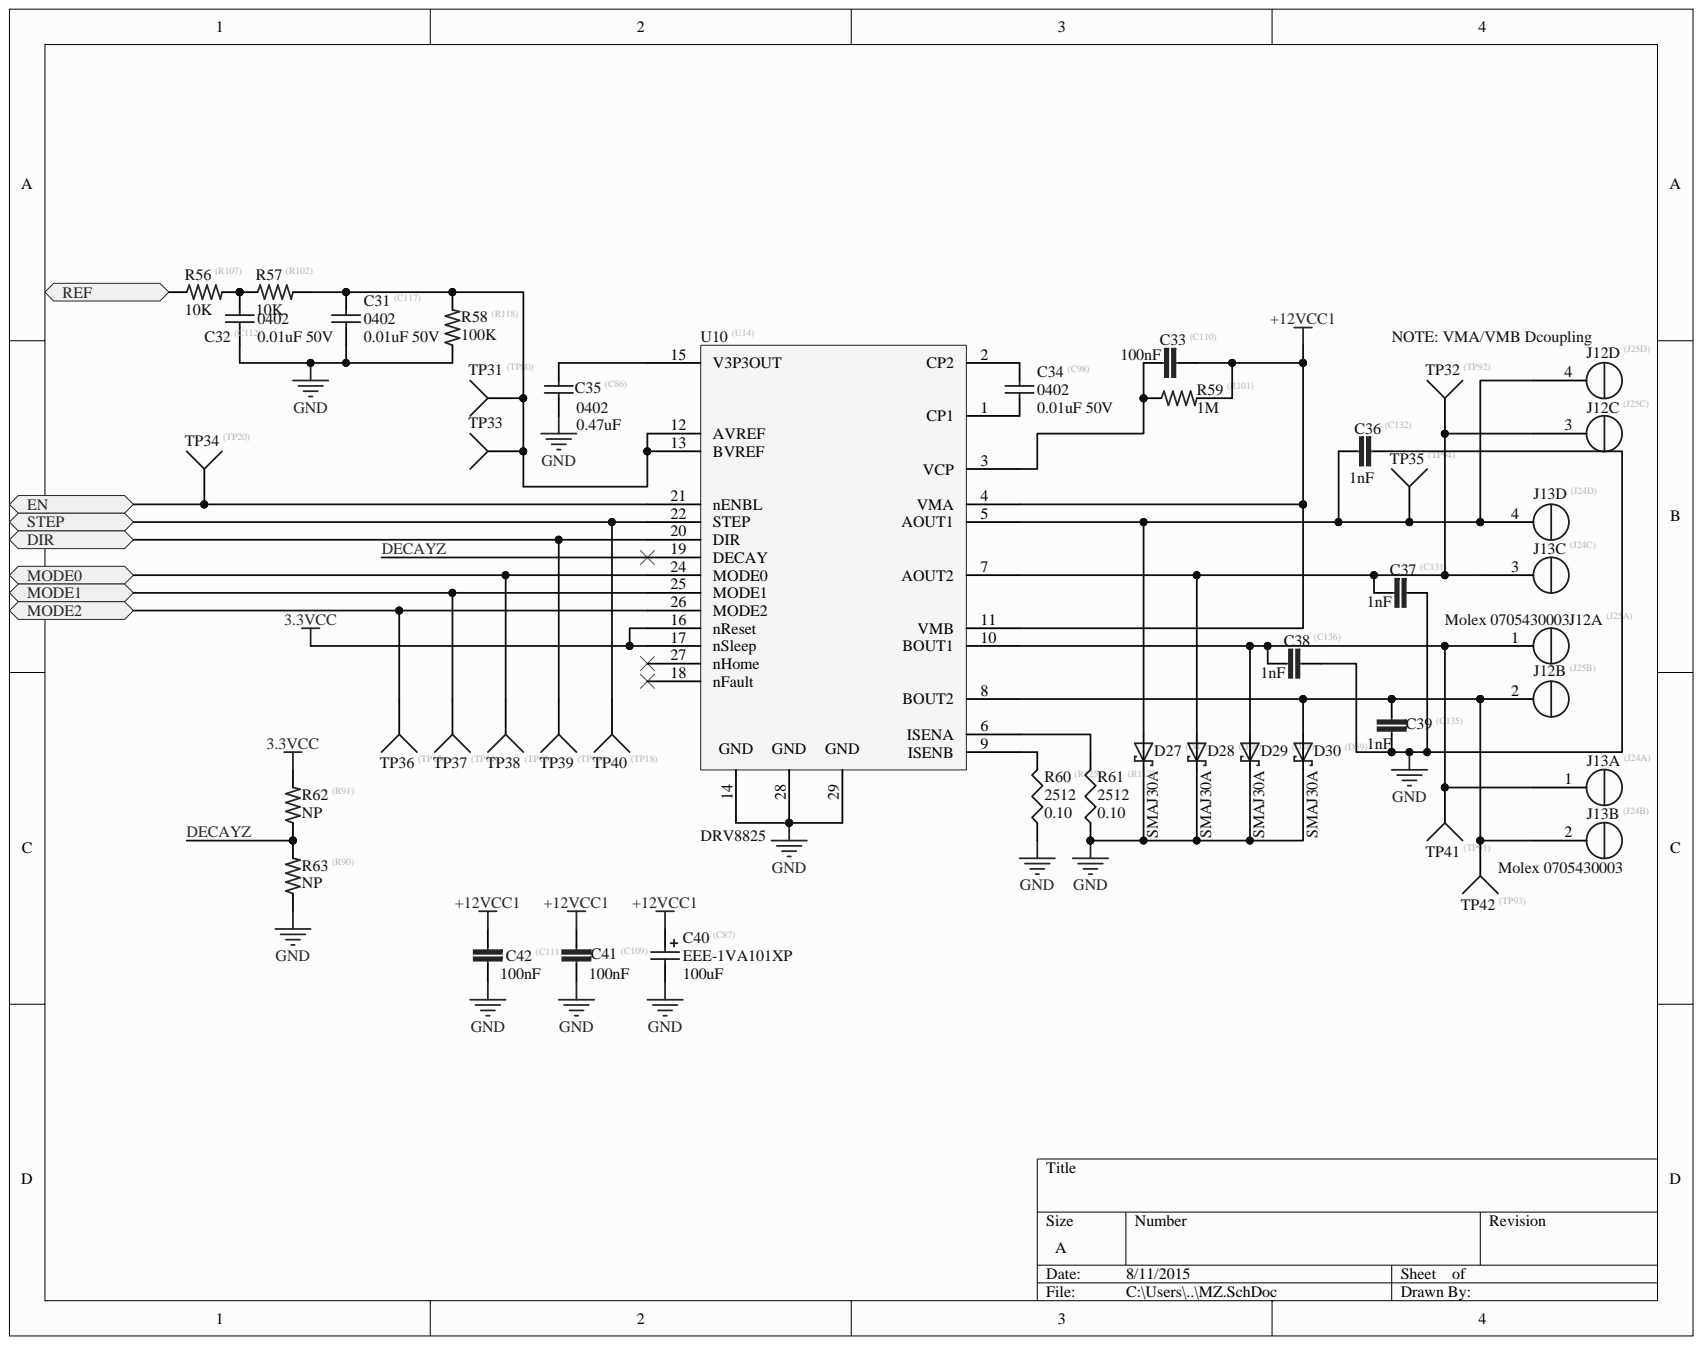
[picture p4: page 4]

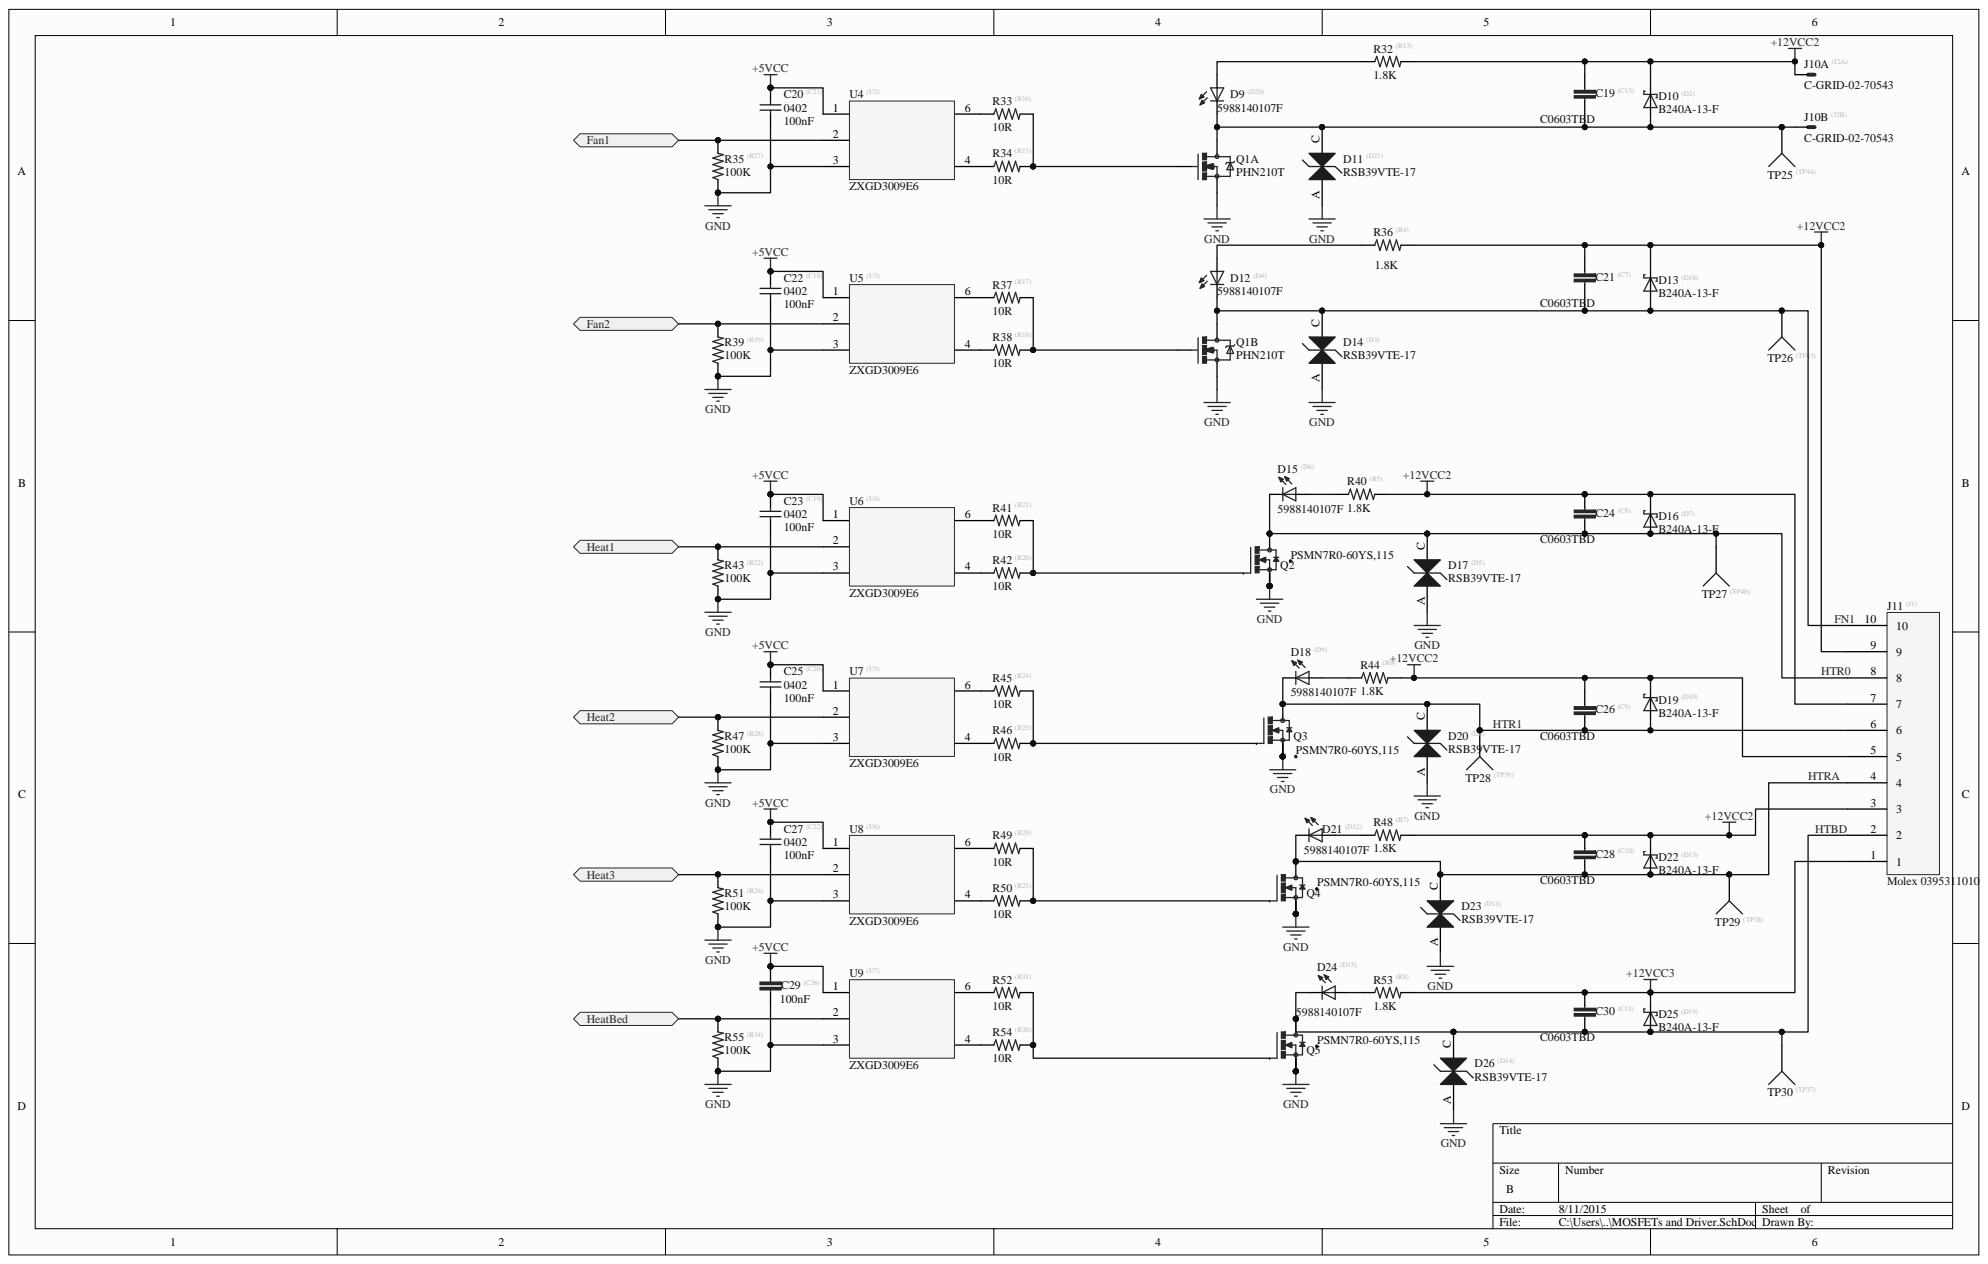
[picture p5: page 5]

Size B | Number | Revision

Date: 8/11/2015 | Sheet of
File: C:\Users\..\MOSFETs and Driver.SchDoc | Drawn By:

A | A

# Thermistor Channel

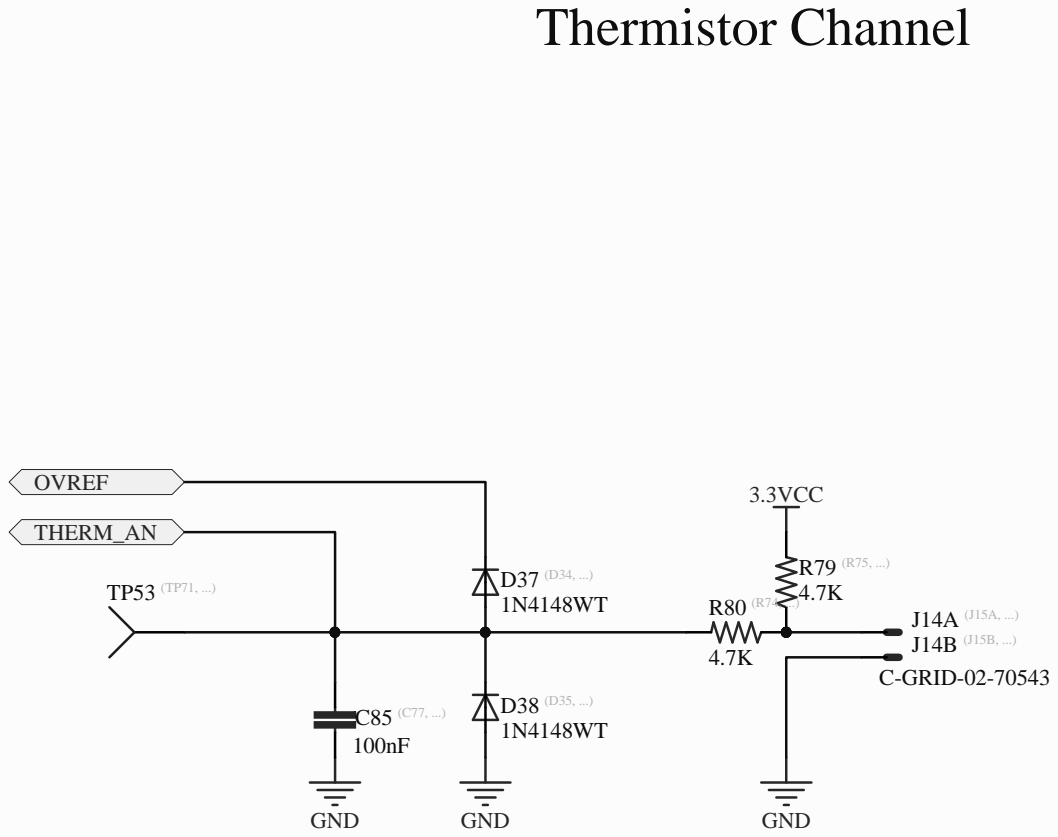
[picture p6: page 6]

A | A

# End Stop Channel

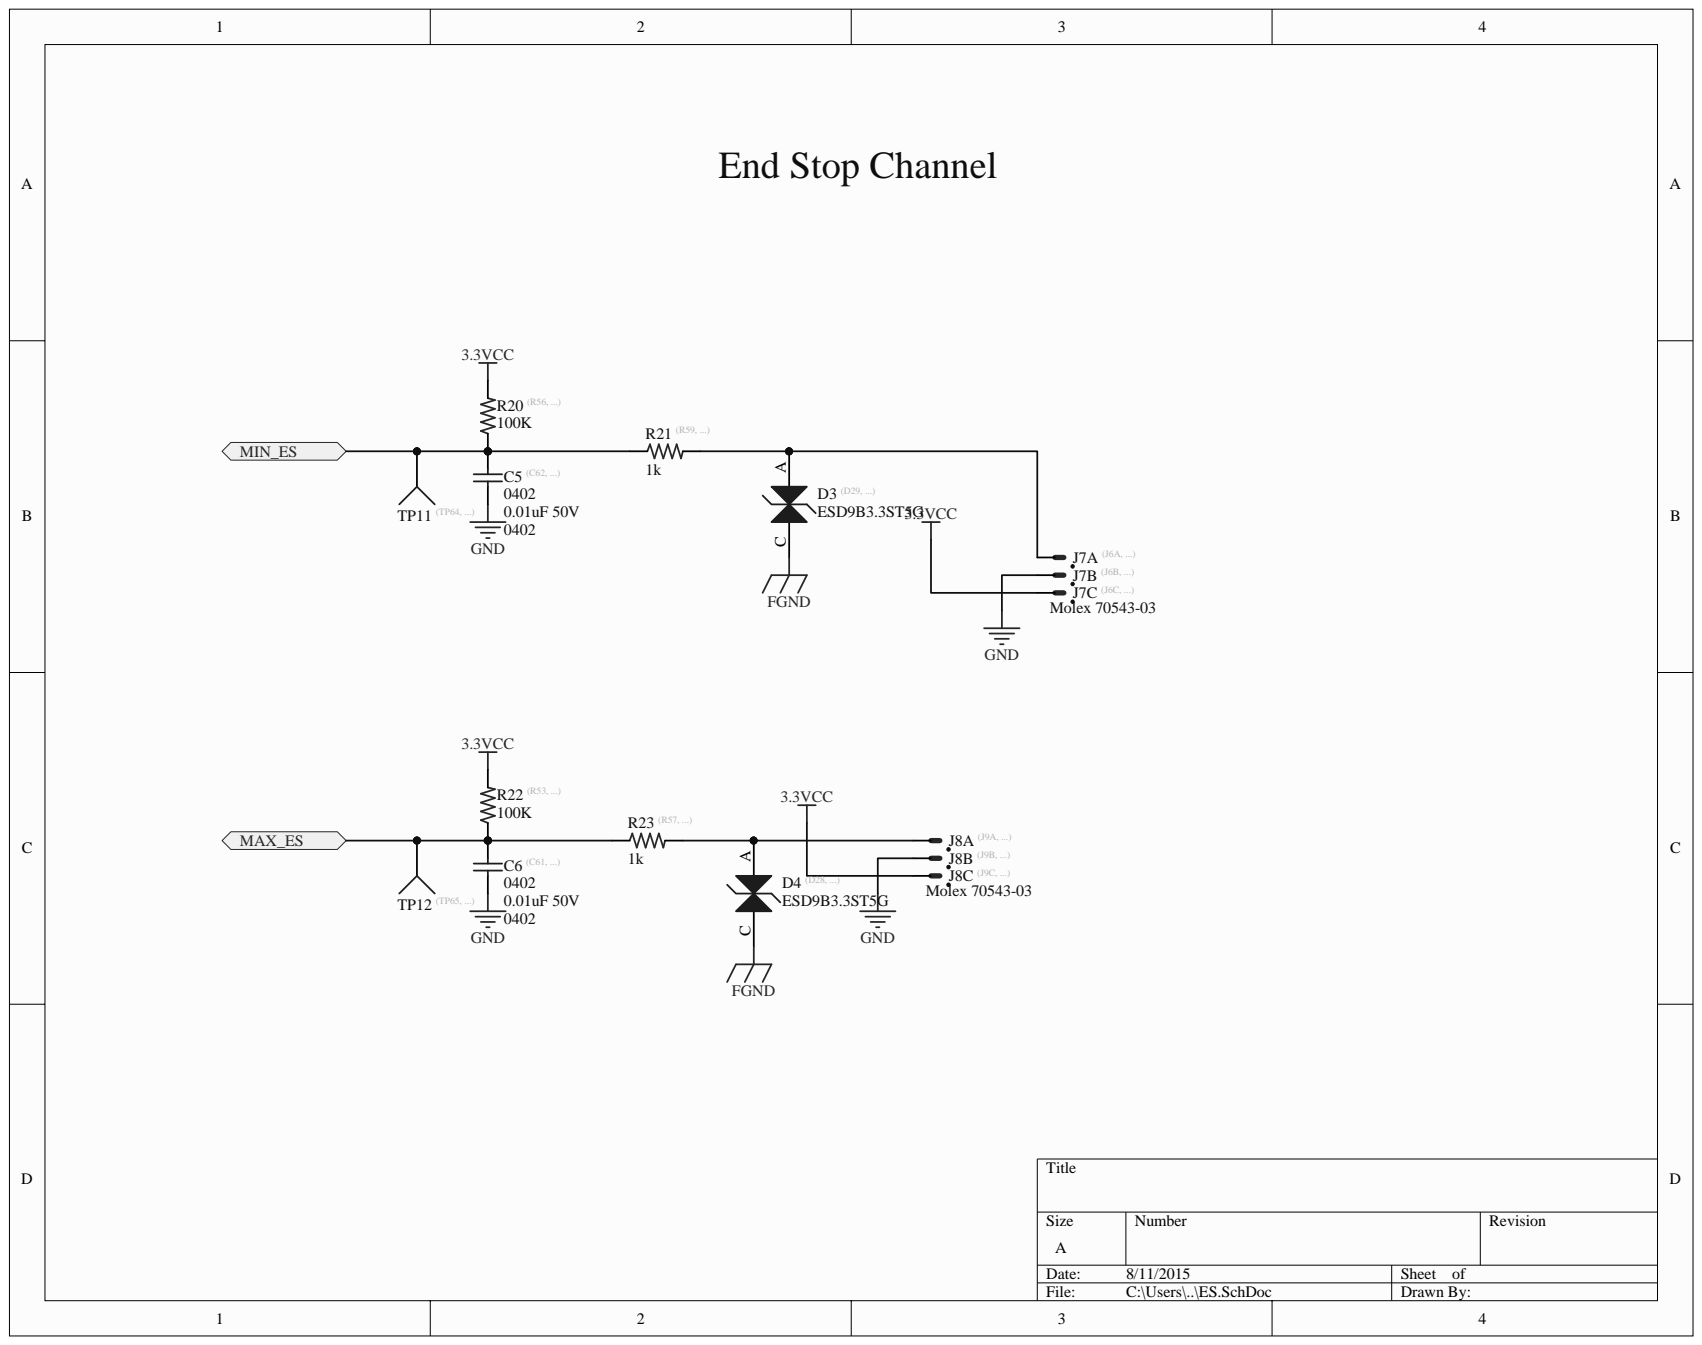
[picture p7: page 7]

A | A

## GND

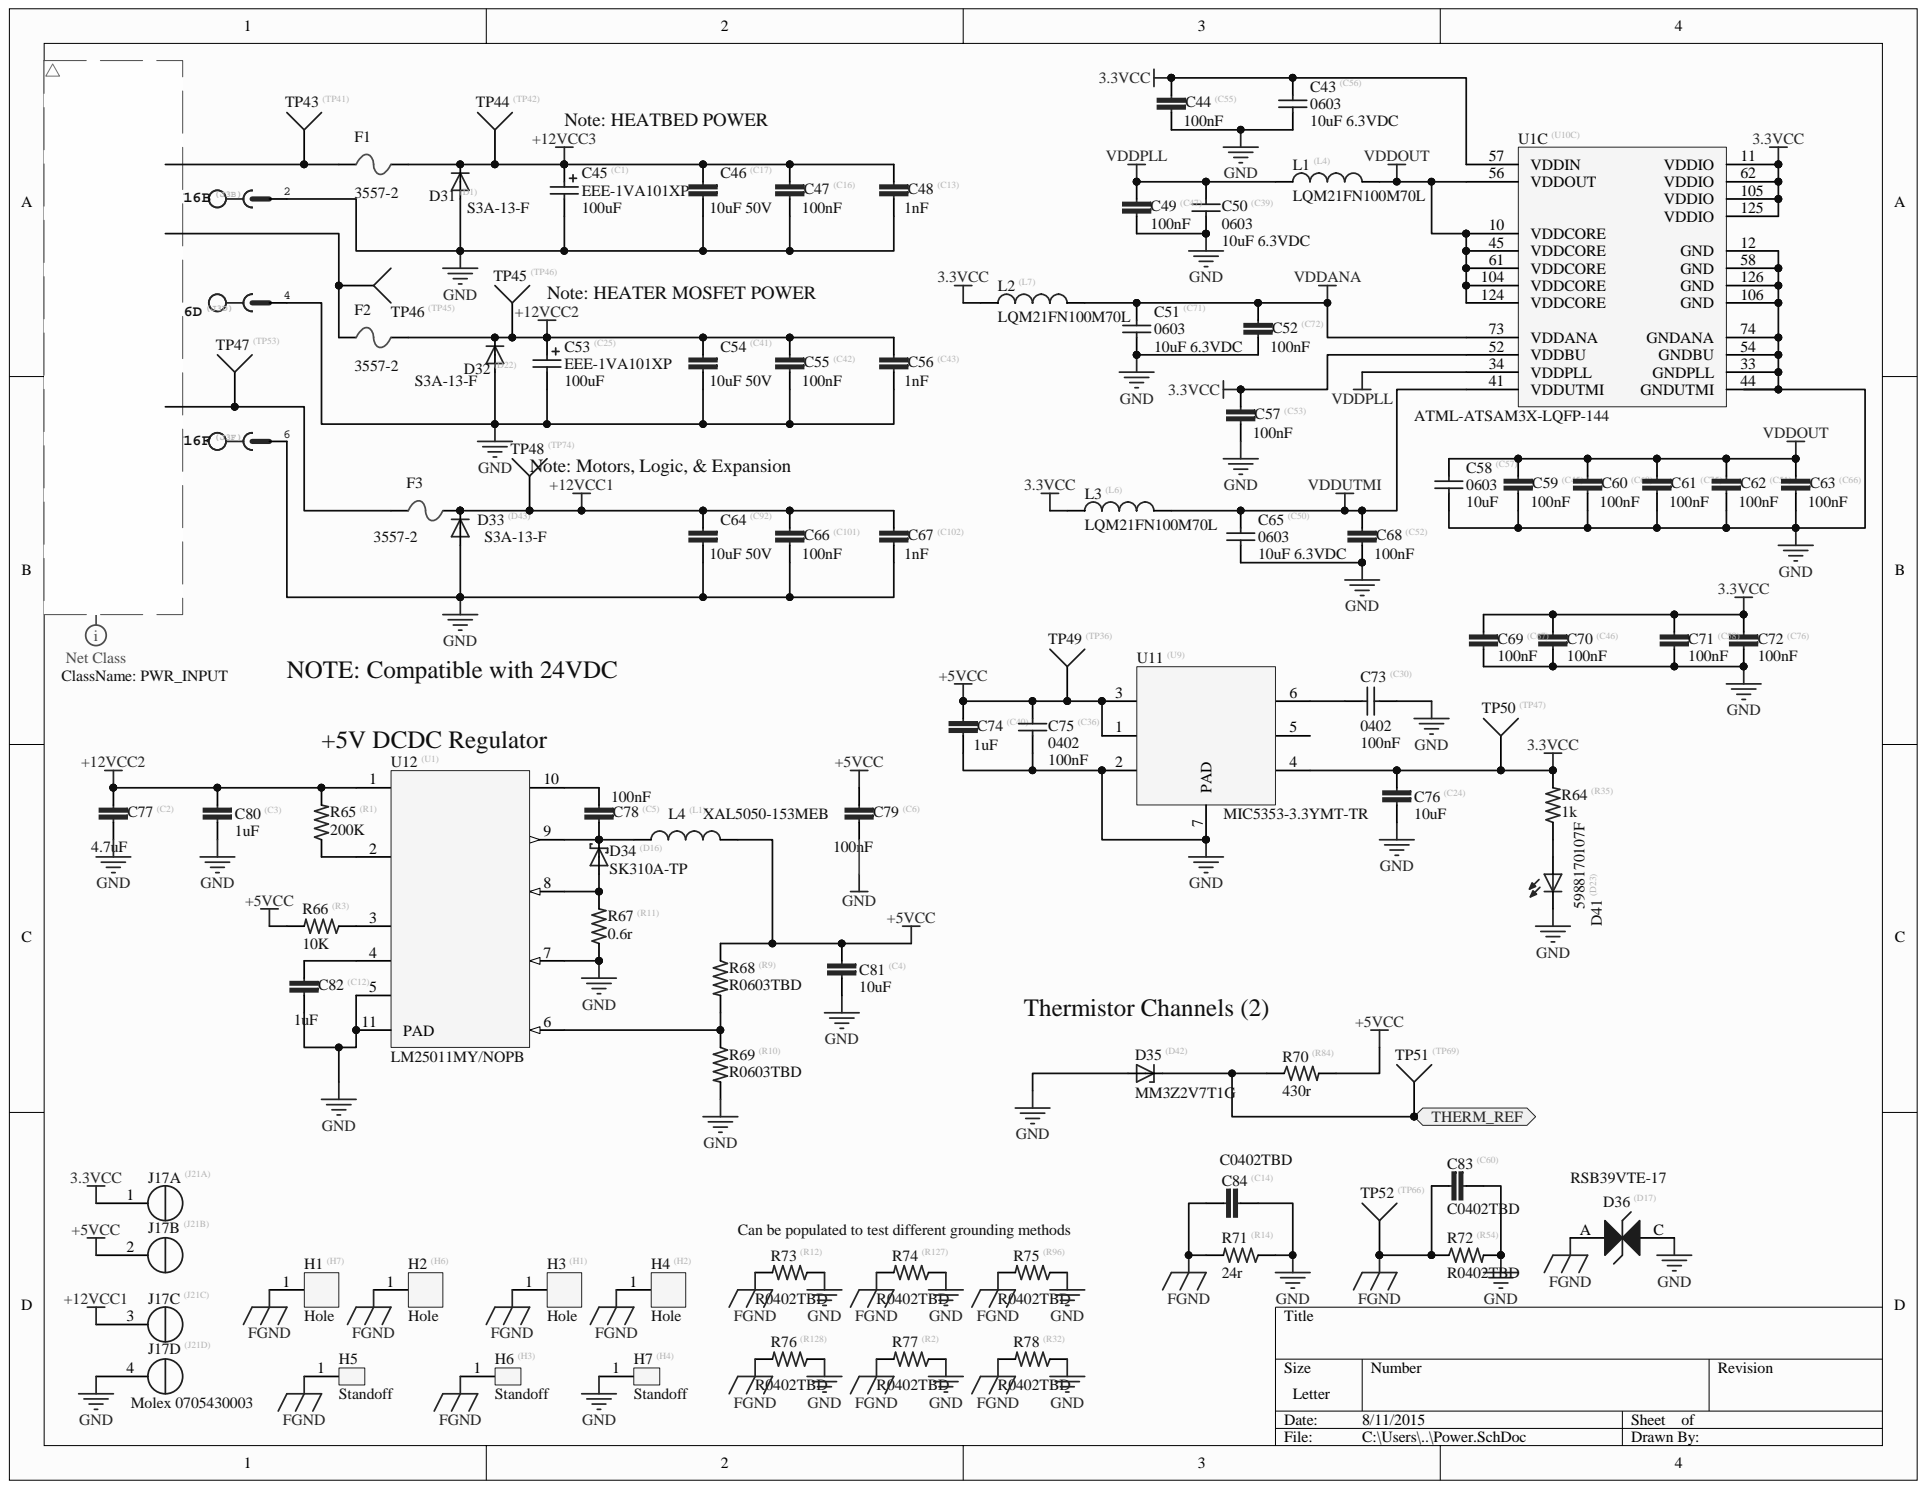
[picture p8: page 8]

Can be populated to test different grounding methods
