mohammadfatemieh/Tigershark3D/PCB-Rev2/Project Outputs for Tigershark 3D rev2 PreProduction Thermistors Version/Tigershark 3D rev2 PreProduction Thermistors Version.PDF

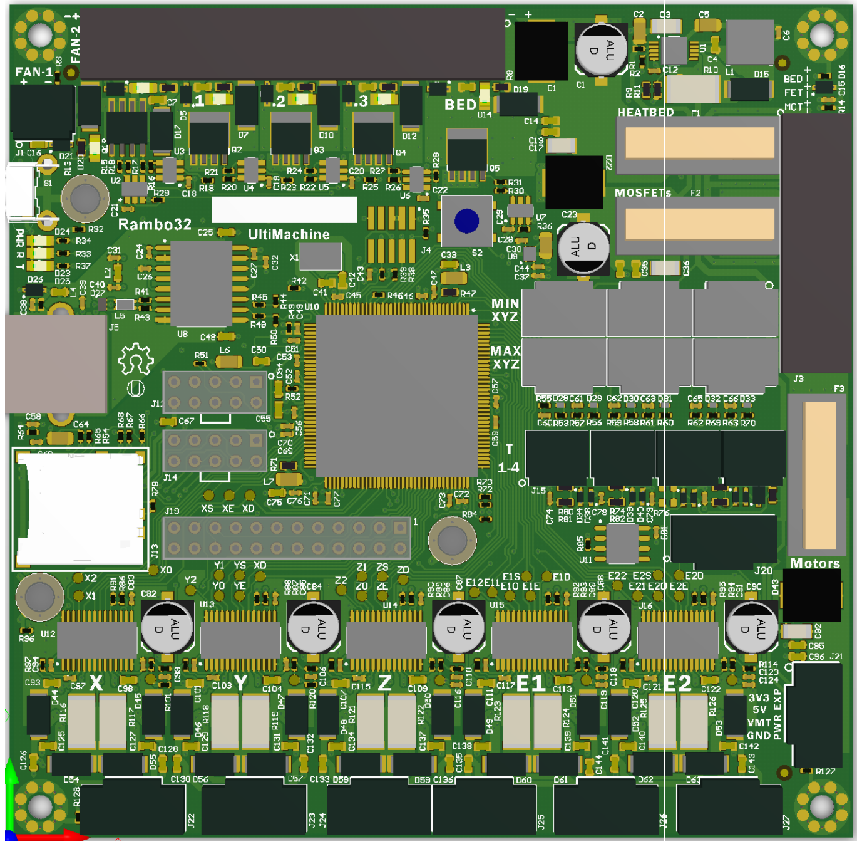
[picture p9: page 1]
