mohammadfatemieh/Tigershark3D/(list of files, drawings)

Other design files:
PCB-Rev2/AMBIT-panel.PcbDoc
PCB-Rev2/ATSAM3X8E Main Controller - TR R1.1.SchDoc
PCB-Rev2/ES.SchDoc
PCB-Rev2/M.SchDoc
PCB-Rev2/MOSFETs and Driver.SchDoc
PCB-Rev2/MZ.SchDoc
PCB-Rev2/Power.SchDoc
PCB-Rev2/ThermistorSim.SchDoc
PCB-Rev2/Tigershark 3D rev2 PreProduction Thermistors Version.PrjPcb
PCB-Rev2/Tigershark-rev2-Panel.PcbDoc
PCB-Rev2/TR.SchDoc
PCB-Rev2/USB.SchDoc
PWMfilterSims.SchDoc
