mohammadfatemieh/Tigershark3D/(commit log)

2015-07-17 Pin changes for routing
    These were committed to PCB in previous commit
    switch pin order MOD2E2=PC23,MOD1E2=PC24,MOD0E2=PB14,STEP2=PB22
    switch
    pin order DIR3=PC10,MOD0E3=PB1,STEP3=PB2,EN3=PC4,MOD1E3=PB0
    [ATSAM3X8E Main Controller - TR R1.1.SchDoc]
2015-07-19 Library work
    Turn courtyards back on for passives
    Use tested libraries where possible
    [ATSAM3X8E Main Controller - TR R1.1.SchDoc, ES.SchDoc, M.SchDoc, MOSFETs and Driver.SchDoc, MZ.SchDoc, Power.SchDoc, TR.SchDoc, Tigershark 3D rev2 PreProduction Thermistors Version.PrjPcb]
2015-07-21 Move USB and reset to match rambo locations
    Update heater connector location and component placement
    JTAG futher
    right, closer to MCU
    re-length matching USB
    add TVS to USB
    add 100nF to
    SD
    Power R10,R12 TBD (not really a change)
    minor schematic cleanup
    tweak
    sd footprint
    working on USB section
    [ATSAM3X8E Main Controller - TR R1.1.SchDoc, BipolarGateDriver.xls, MOSFETs and Driver.SchDoc, PWMfilterSims.SchDoc, Power.SchDoc, Tigershark 3D rev2 PreProduction Thermistors Version1.xlsx]
2015-07-23 working on new pin mapping, etc
    new pwm filter.
    all 10K = 0402
    [ATSAM3X8E Main Controller - TR R1.1.SchDoc, ES.SchDoc, M.SchDoc, MZ.SchDoc, PWMfilterSims.SchDoc, Power.SchDoc, ThermistorSim.SchDoc]
2015-07-24 Change gate drivers
    drive fets with ZXGD3009E6TA
    fan = PHN210T add flyback and esd
    heaters
    add esd
    [ATSAM3X8E Main Controller - TR R1.1.SchDoc, MOSFETs and Driver.SchDoc, Tigershark 3D rev2 PreProduction Thermistors Version.PrjPcb]
2015-07-24 extension spacing advref cap
    increase extension connector spacing
    additional decoupling on ADVREF
    [ATSAM3X8E Main Controller - TR R1.1.SchDoc]
2015-08-04 rework extensions
    additional decoupling on
    ADVREF
    pull ups on jtag
    change pin mapping to break out useful
    signals
    motor bulk caps now smt
    break ethernet out
    bring out all of 1
    serial line, verify spi, i2c, few adc, pwms
    add extension standoff
    holes
    add erase button
    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
    [ATSAM3X8E Main Controller - TR R1.1.SchDoc, M.SchDoc, MOSFETs and Driver.SchDoc, MZ.SchDoc, PWMfilterSims.SchDoc, Power.SchDoc, calcs.ods]
2015-08-07 routing
    straighten drivers
    sj -> nettie for gnd to fgnd. add cap and resistor
    for potential gnd - fgnd connection
    straighten fets
    change tvs on
    endstops
    spacing for sd traces
    Move SD decoupling so it doesn't pass
    through vias
    route out from under sd
    endstop section reworked
    esd to
    fgnd
    source terminating resistors to spi
    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
    [ATSAM3X8E Main Controller - TR R1.1.SchDoc, ES.SchDoc, MOSFETs and Driver.SchDoc, Power.SchDoc, Tigershark 3D rev2 PreProduction Thermistors Version.PrjPcb, Tigershark 3D rev2 PreProduction Thermistors Version.xls]
2015-08-10 USB
    access last pwm & tio
    1K resistors 0402
    R7 -> 0402
    add np resistors to combine a couple pins to access last pwm & tio
    1K
    resistors 0402
    USB terminating resistors 0402 and all 24r
    move tc1(A) to
    extension freeing all of this timer
    some schematic cleanup
    USB common
    mode choke, esd, routing
    [ATSAM3X8E Main Controller - TR R1.1.SchDoc, Power.SchDoc, Rambott.xls]
2015-08-10 MCU cleanup
    jtag 20021121-00010C4LF
    Thermistor Zener current limit resistor 430R
    RC0603JR-07430RL
    gnd poly under mcu
    update crystal and caps
    [ATSAM3X8E Main Controller - TR R1.1.SchDoc, Power.SchDoc]
2015-08-11 power routing
    mosfets
    power inputs
    move power input to match rambo
    power plane
    clearance = 10
    power plane under mosfets now gnd
    add decoupling to fet
    outputs
    connect gnd to fgnd with 24r and tvs
    clear major dr errors
    [MOSFETs and Driver.SchDoc, Power.SchDoc, TR.SchDoc]
2015-08-11 stackup
    motor driver plane via stitching
    new stackup
    via stitching
2015-08-11 cleanup
    testpoint on
    usb powers and fgnd
    usb traces to 10mil
    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
    [ATSAM3X8E Main Controller - TR R1.1.SchDoc, Power.SchDoc]
2015-08-12 working on annotation
    [ATSAM3X8E Main Controller - TR R1.1.SchDoc, ES.SchDoc, M.SchDoc, MOSFETs and Driver.SchDoc, MZ.SchDoc, Power.SchDoc, TR.SchDoc, Tigershark 3D rev2 PreProduction Thermistors Version.PrjPcb]
2015-08-12 Reannotate and top silk
    previous commit message missed:
    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
    [ATSAM3X8E Main Controller - TR R1.1.SchDoc, ES.SchDoc, M.SchDoc, MOSFETs and Driver.SchDoc, MZ.SchDoc, Power.SchDoc, TR.SchDoc, Tigershark 3D rev2 PreProduction Thermistors Version.PrjPcb]
2015-08-12 minor tweaks
    Bottom Silk fixes
    remove paste from test points
    fix rrd miso mosi
    mixup
    pin 1 mark for connectors
    [ATSAM3X8E Main Controller - TR R1.1.SchDoc, Power.SchDoc]
2015-08-12 shift lower left passives in a little for clearance
    from mounting hole
2015-08-13 pre-prototype cleanup
    plane clearances 7 mil
    version #
    driver thermal tents
    change bottom silk
    font
    add version number
    resize sheets to american sizes
    output job
    work
    fix driver thermal via tents
    rename Ambit
    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
    [AMBIT-panel.PcbDoc, ATSAM3X8E Main Controller - TR R1.1.SchDoc, ES.SchDoc, M.SchDoc, MOSFETs and Driver.SchDoc, MZ.SchDoc, TR.SchDoc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]
